jaesparza/radio-beacon/doc/README.md

## References

* [Blue Pill STM32F103C8T6 data in STM32 base](https://stm32-base.org/boards/STM32F103C8T6-Blue-Pill.html)
* [AN3371 Using the STM32 hardware real-time clock (RTC)](https://www.st.com/content/ccc/resource/technical/document/application_note/7a/9c/de/da/84/e7/47/8a/DM00025071.pdf/files/DM00025071.pdf/jcr:content/translations/en.D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)
* [NEO-6 u-blox 6 GPS Module datasheet](https://www.u-blox.com/sites/default/files/products/documents/NEO-6_DataSheet_%28GPS.G6-HW-09005%29.pdf)

## Schematics

### AD9850 Schematic
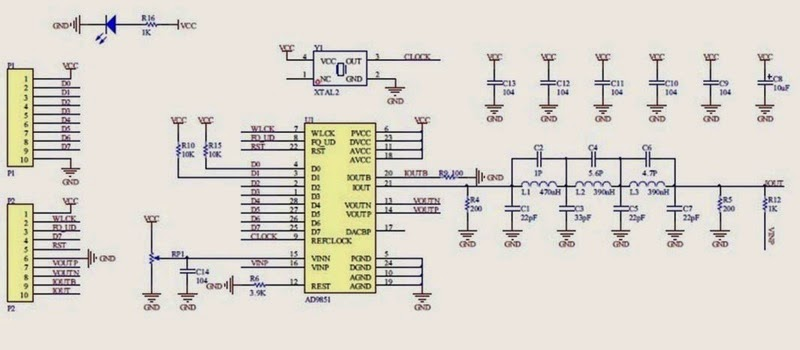
[picture p4: doc/images/ad9850BreakOut.jpg]
adBreakoutBoard


### STM32 Bluepill
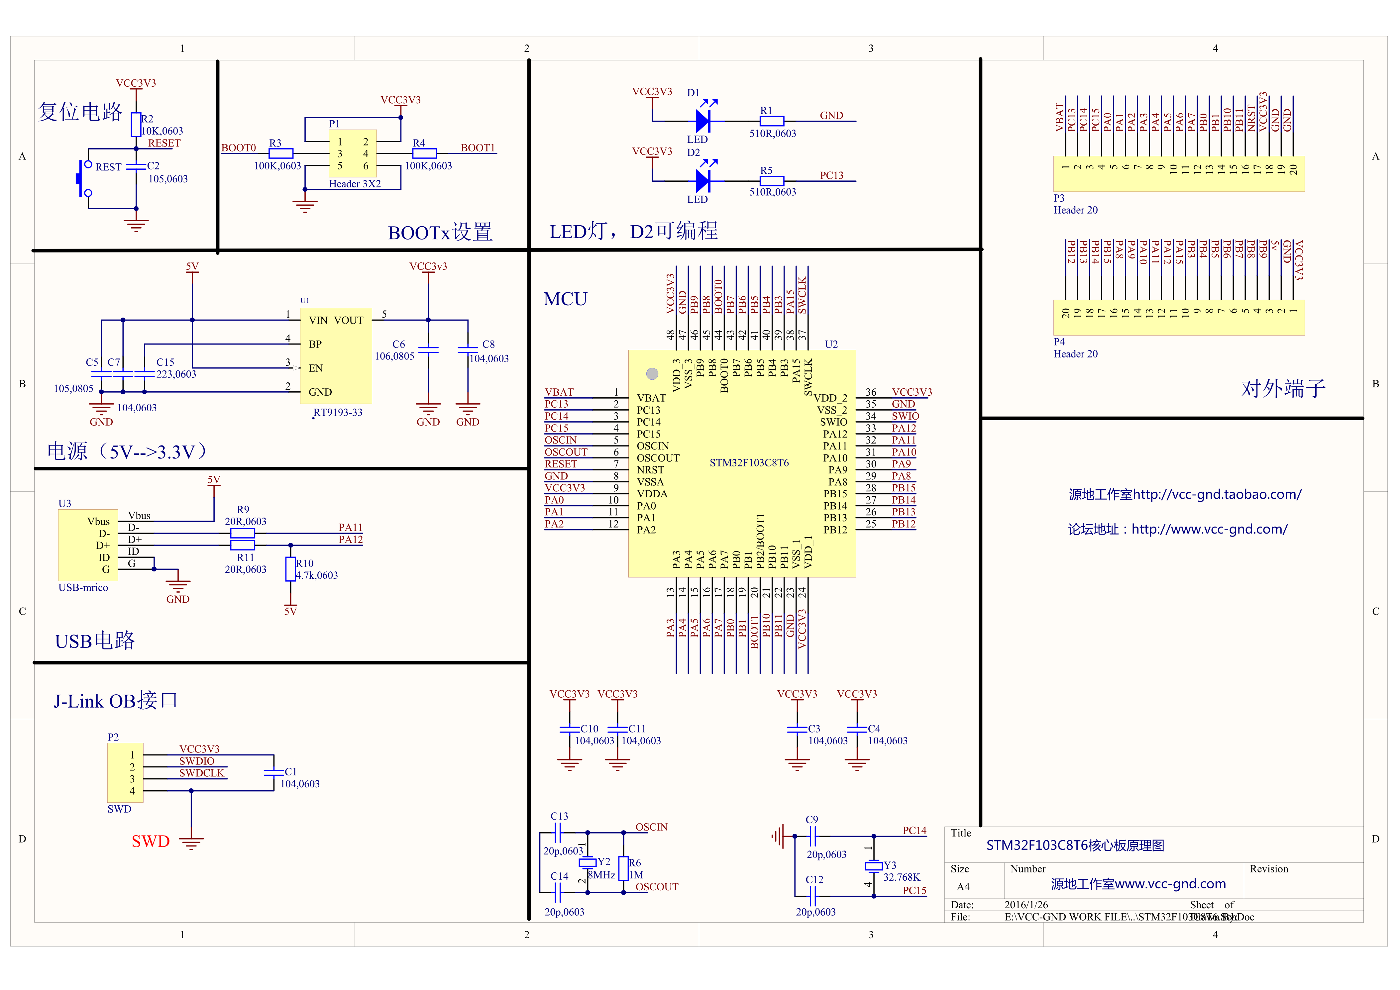
[picture p5: doc/images/bpSchematic.png]
bpSchematic


### GPS breakout board
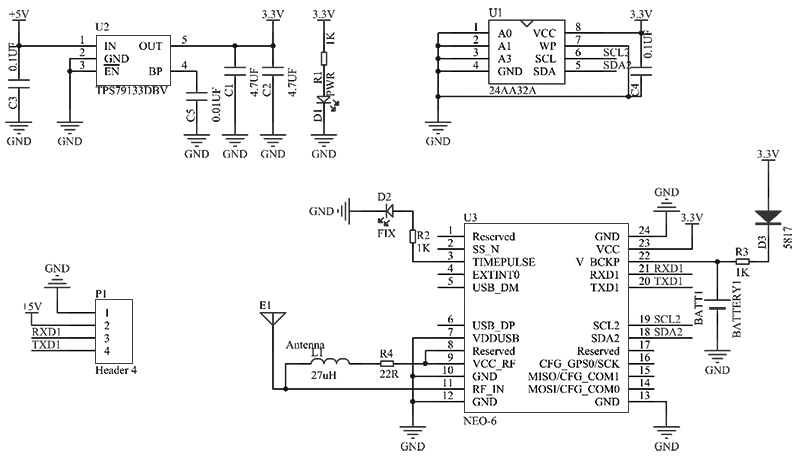
[picture p6: doc/images/UbloxNeo6.jpg]
