jaesparza/radio-beacon/doc/images/amplifierOut.png

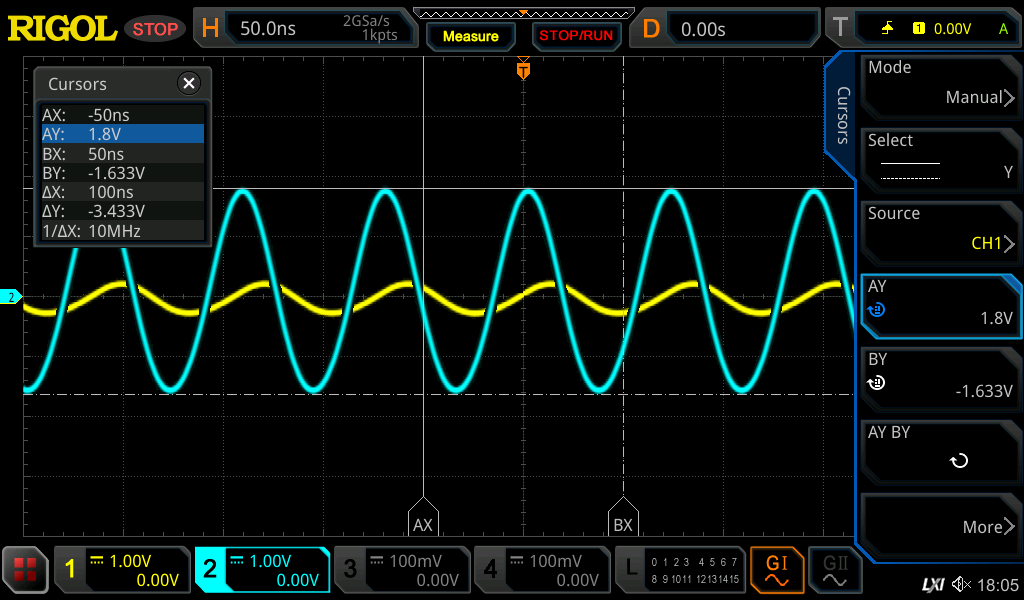
doc/images/amplifierOut.png
