jaesparza/radio-beacon/doc/images/contacts1.PNG

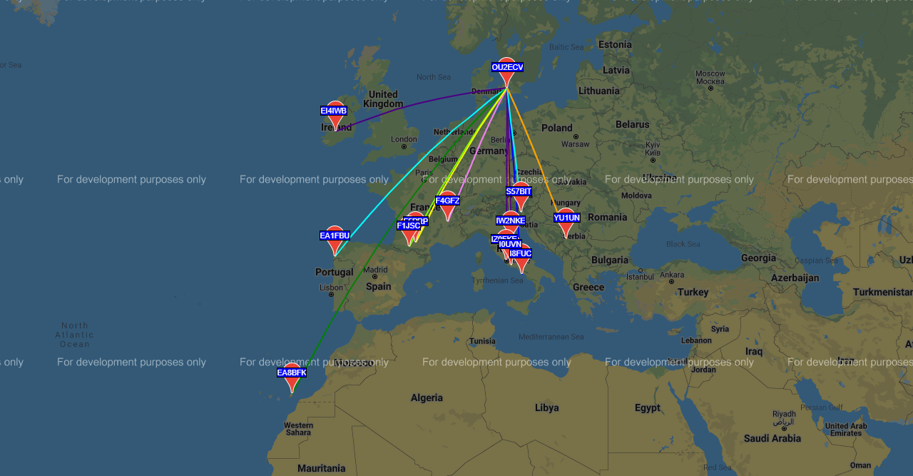
doc/images/contacts1.PNG
