jaesparza/radio-beacon/doc/images/drift.PNG

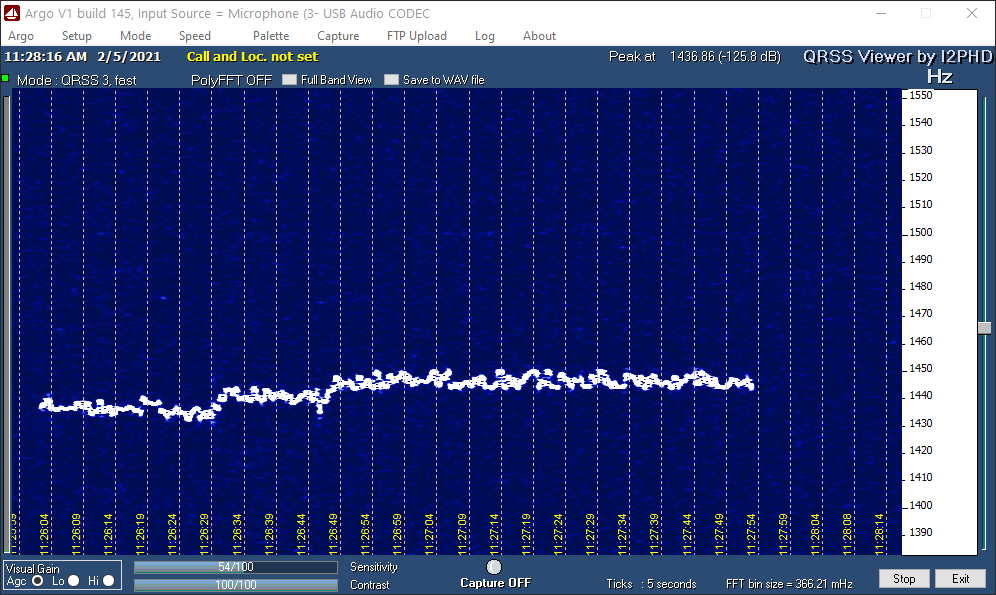
doc/images/drift.PNG
