jaesparza/radio-beacon/doc/images/rxWSJT-X.PNG

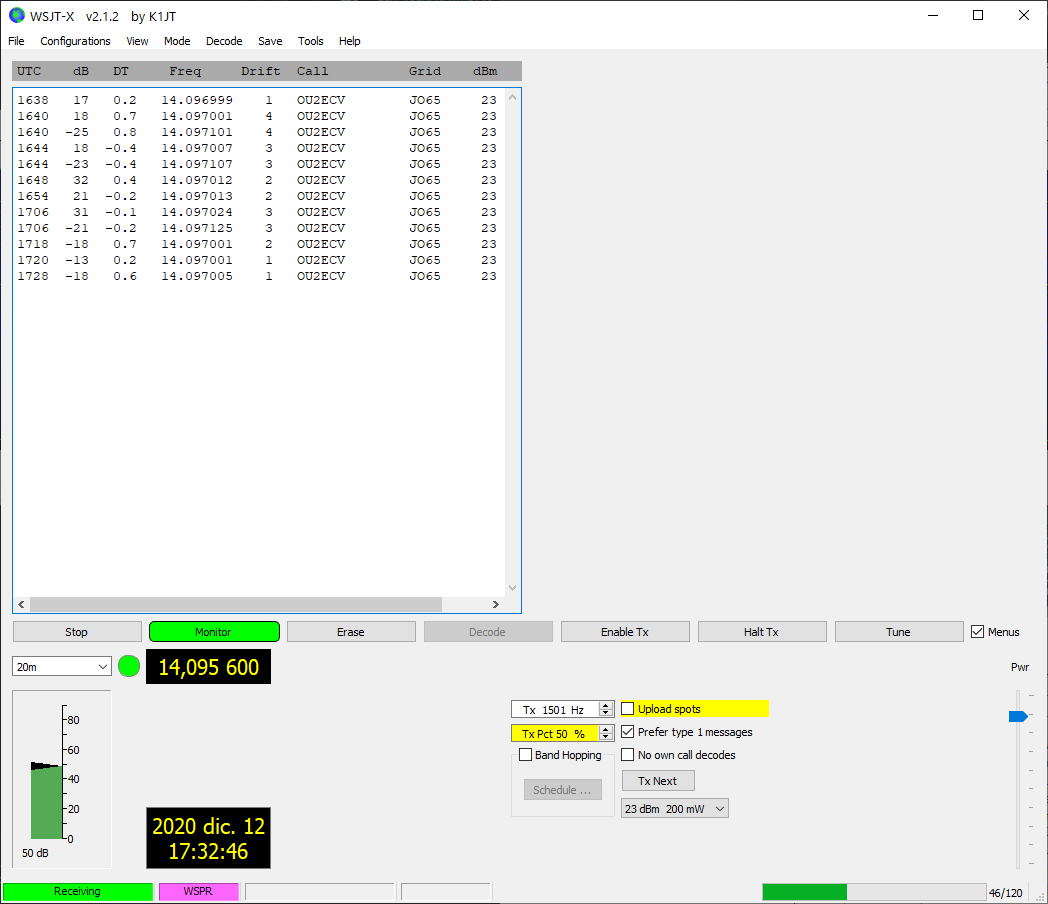
doc/images/rxWSJT-X.PNG
