jaesparza/radio-beacon/doc/images/WSPR.PNG

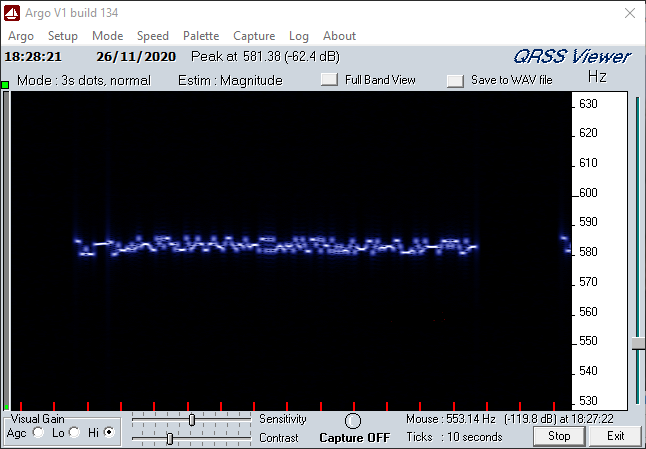
doc/images/WSPR.PNG
