jaesparza/radio-beacon/doc/images/testTones.PNG

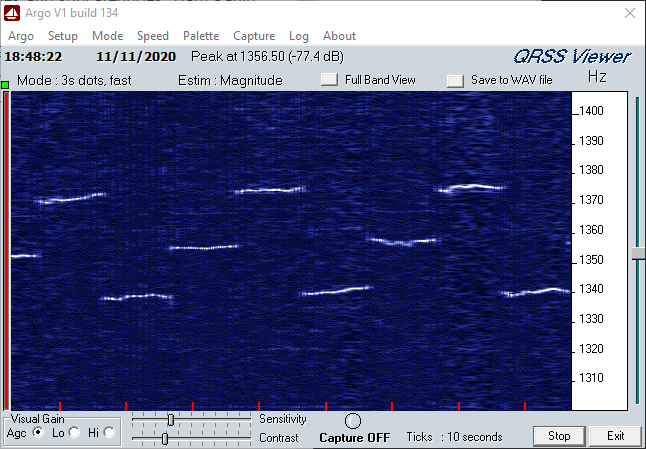
doc/images/testTones.PNG
