jaesparza/radio-beacon/(commit log)

2020-11-11 Refactored so SPI interface selected in the constructor.
2020-11-17 Align pin declaration naming
2020-11-19 Added calibration method
2020-11-23 Introduced CW_DELAY define to avoid hardcoded constant
    [QRSS.cpp, QRSS.h]
2020-11-28 Pins renamed to avoid conflict with alternative STM32 core
    [HardwareConfig.h, beacon.ino]
2020-12-01 RTC sync prototype
    RTC syncing to GPS time has to be extracted to the TimeSync object later on.
2020-12-02 Added schematics
2021-04-08 Added schematics for the PA
    [LPF.sch, radio-beacon.kicad_pcb, radio-beacon.sch]
2021-04-09 Disable oscillator when message has been transmitted completely
    [WSPR.cpp]
